hanebuechenes/synapsNOISE/production/bom.csv

Designator | Footprint | Quantity | Value | LCSC Part #
C1, C2, C20, C3, C4, C5, C6 | 0603 | 7 | 100nF
C10, C11, C14, C7 | 0603 | 4 | 100nF 50V X7R
C12, C8 | CP_Elec_6.3x7.7 | 2 | 100uF 25V
C13, C9 | 0805 | 2 | 10uF 25V X7R
C15, C27, C33 | 0603 | 3 | 1nF
C16, C23 | 0603 | 2 | 10u
C17 | 0603 | 1 | 10nF
C18, C19 | 0603 | 2 | 1uF
C21 | 0603 | 1 | 1u
C22 | 0603 | 1 | 100p
C24, C31 | 0603 | 2 | 4,7nF
C25 | 0603 | 1 | 6,8nF
C26, C32 | 0603 | 2 | 2,2nF
C28, C30 | 0603 | 2 | 68p
C29 | 0603 | 1 | 1n
C34 | 0603 | 1 | 100pF
D1, D2 | D_SMA-SMB_Universal_Handsoldering | 2 | MBRA140T3G
D3 | D_SOD-123 | 1 | 1N4733A
D4, D5 | D_SOD-123 | 2 | 1N4148W
F1, F2 | 1210 | 2 | Polyfuse
FB1, FB2 | 0603 | 2 | 120R@100MHz 2A
J1 | PinHeader_2x05_P2.54mm_Vertical | 1 | Eurorack Header
J2 | PJ301M-12 | 1 | White Out
J3 | PJ301M-12 | 1 | Red Out
J4 | PJ301M-12 | 1 | Blue Out
J5 | PJ301M-12 | 1 | Violet Out
J6 | PJ301M-12 | 1 | Pink Out
J7 | PJ301M-12 | 1 | Grainy Out
J8 | PJ301M-12 | 1 | J_Grainy_CV
J9 | PJ301M-12 | 1 | Mix Out
MIX_BLUE1, MIX_GRAINY1, MIX_PINK1, MIX_RED1, MIX_VIOLET1, MIX_WHITE1, RV_GRAINY_CV1 | RES-TH_RK09K1130A70 | 7 | B100k
NOISELEVEL1 | RES-TH_RK09K1130A70 | 1 | 500k
Q1 | TO-92_Inline | 1 | BC337
R1 | 0603 | 1 | 1M
R10 | 0603 | 1 | 470k
R11, R33, R35, R4, R6, R9 | 0603 | 6 | 10k
R12, R15, R21, R25, R31, R47 | 0603 | 6 | 1k
R13, R17, R26 | 0603 | 3 | 51k
R14, R27, R5 | 0603 | 3 | 47k
R16, R28, R36 | 0603 | 3 | 200k
R18, R22 | 0603 | 2 | 8,2k
R19, R23 | 0603 | 2 | 33k
R2, R29, R3, R32, R34, R39, R40, R41, R42, R43, R44, R45, R46, R7, R8 | 0603 | 15 | 100k
R20, R24, R37 | 0603 | 3 | 4,7k
R30 | 0603 | 1 | 20k
R38 | 0603 | 1 | 3,3k
RV_BLUE1, RV_CHARACTER1, RV_VIOLET1 | RES-TH_RK09K1130A70 | 3 | 100k
RV_GRAININESS1 | RES-TH_RK09K1130A70 | 1 | 50k
RV_PINK1, RV_RED1 | RES-TH_RK09K1130A70 | 2 | 1M
SW1 | SW_NKK_GW12LJP | 1 | SW_SP3T
U1, U2 | SOIC-14_3.9x8.7mm_P1.27mm | 2 | TL074
U3 | SOIC-8_3.9x4.9mm_P1.27mm | 1 | TL072
U4 | SOP-14_L8.7-W3.9-P1.27-LS6.0-BL | 1 | CD4093BM_C5456626 | C5456626
