hanebuechenes/synapsNOISE/(list of files, drawings)

Other design files:
sch_data.json
