hanebuechenes/synapsNOISE/synapsNOISE.kicad_pcb

## KiCad design synapsNOISE.kicad_pcb (2026-11-06)

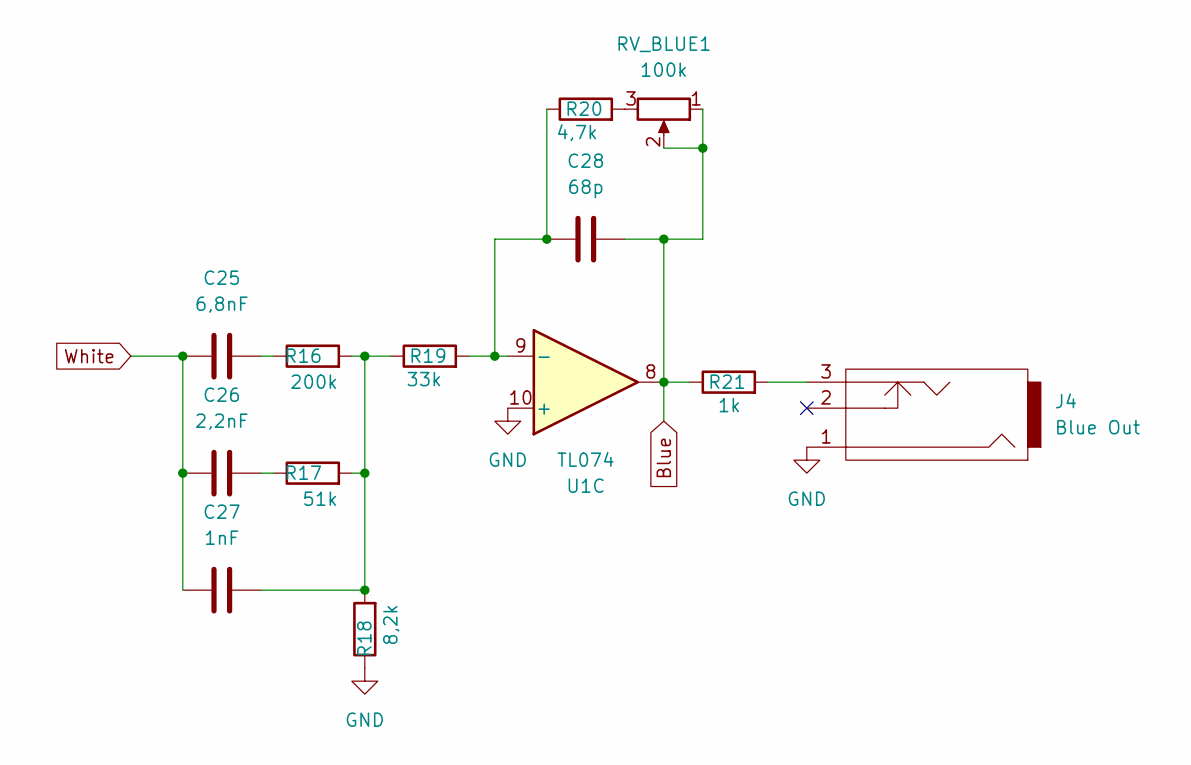
[picture p1: schematic bluenoise.kicad_sch]

Parts:
C25: 6,8nF; C_0603_1608Metric_Pad1.08x0.95mm_HandSolder
C26: 2,2nF; C_0603_1608Metric_Pad1.08x0.95mm_HandSolder
C27: 1nF; C_0603_1608Metric_Pad1.08x0.95mm_HandSolder
C28: 68p; C_0603_1608Metric_Pad1.08x0.95mm_HandSolder
J4: Blue Out; PJ301M-12; MFG Part Number WQP-WQP518MA; Digikey Part Number N/A
R16: 200k; R_0603_1608Metric_Pad0.98x0.95mm_HandSolder
R17: 51k; R_0603_1608Metric_Pad0.98x0.95mm_HandSolder
R18: 8,2k; R_0603_1608Metric_Pad0.98x0.95mm_HandSolder
R19: 33k; R_0603_1608Metric_Pad0.98x0.95mm_HandSolder
R20: 4,7k; R_0603_1608Metric_Pad0.98x0.95mm_HandSolder
R21: 1k; R_0603_1608Metric_Pad0.98x0.95mm_HandSolder
RV_BLUE1: 100k; RES-TH_RK09K1130A70
U1: TL074; SOIC-14_3.9x8.7mm_P1.27mm

Connections:
GND: J4.1, R18.1, U1.10 (+); also elsewhere on the board
unnamed: C25.1, R16.1
unnamed: C26.1, R17.1
unnamed: C27.1, R16.2, R17.2, R18.2, R19.1
unnamed: C28.1, R21.1, RV_BLUE1.1, RV_BLUE1.2, U1.8
unnamed: J4.3, R21.2
unnamed: R20.2, RV_BLUE1.3
unnamed: C28.2, R19.2, R20.1, U1.9 (-)
White: C25.2, C26.2, C27.2; also elsewhere on the board

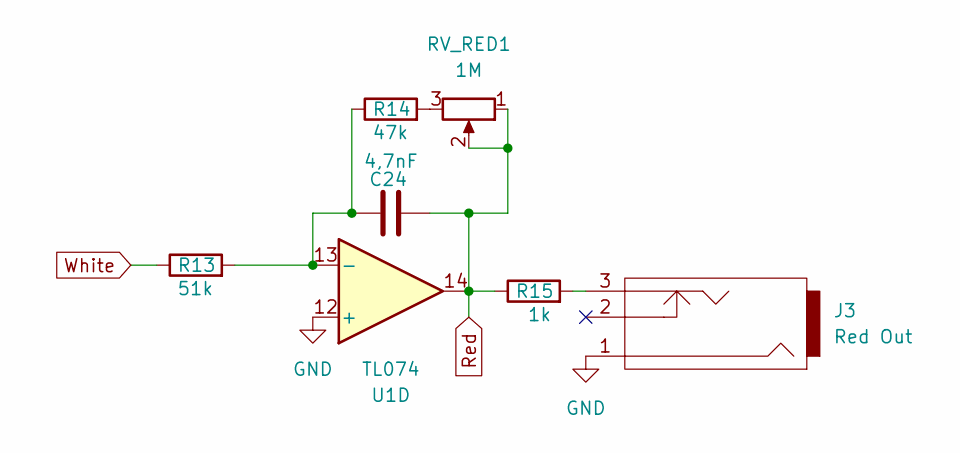
[picture p2: schematic rednoise.kicad_sch]

Parts:
C24: 4,7nF; C_0603_1608Metric_Pad1.08x0.95mm_HandSolder
J3: Red Out; PJ301M-12; MFG Part Number WQP-WQP518MA; Digikey Part Number N/A
R13: 51k; R_0603_1608Metric_Pad0.98x0.95mm_HandSolder
R14: 47k; R_0603_1608Metric_Pad0.98x0.95mm_HandSolder
R15: 1k; R_0603_1608Metric_Pad0.98x0.95mm_HandSolder
RV_RED1: 1M; RES-TH_RK09K1130A70
U1: TL074; SOIC-14_3.9x8.7mm_P1.27mm

Connections:
GND: J3.1, U1.12 (+); also elsewhere on the board
unnamed: C24.1, R15.1, RV_RED1.1, RV_RED1.2, U1.14
unnamed: J3.3, R15.2
unnamed: R14.2, RV_RED1.3
unnamed: C24.2, R13.2, R14.1, U1.13 (-)
White: R13.1; also elsewhere on the board

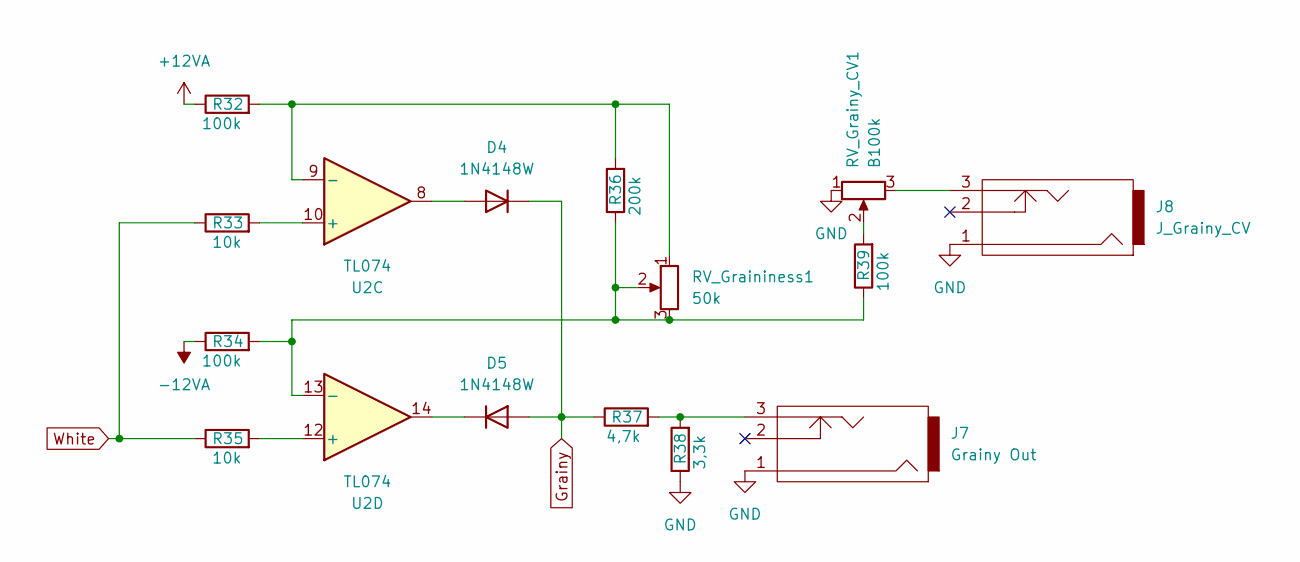
[picture p3: schematic grainyout.kicad_sch]

Parts:
D4, D5: 1N4148W; D_SOD-123
J7: Grainy Out; PJ301M-12; MFG Part Number WQP-WQP518MA; Digikey Part Number N/A
J8: J_Grainy_CV; PJ301M-12; MFG Part Number WQP-WQP518MA; Digikey Part Number N/A
R32, R34, R39: 100k; R_0603_1608Metric_Pad0.98x0.95mm_HandSolder
R33, R35: 10k; R_0603_1608Metric_Pad0.98x0.95mm_HandSolder
R36: 200k; R_0603_1608Metric_Pad0.98x0.95mm_HandSolder
R37: 4,7k; R_0603_1608Metric_Pad0.98x0.95mm_HandSolder
R38: 3,3k; R_0603_1608Metric_Pad0.98x0.95mm_HandSolder
RV_Graininess1: 50k; RES-TH_RK09K1130A70
RV_Grainy_CV1: B100k; RES-TH_RK09K1130A70
U2: TL074; SOIC-14_3.9x8.7mm_P1.27mm

Connections:
+12VA: R32.1; also elsewhere on the board
-12VA: R34.1; also elsewhere on the board
GND: J7.1, J8.1, R38.1, RV_Grainy_CV1.1; also elsewhere on the board
unnamed: D4.2 (A), U2.8
unnamed: D4.1 (K), D5.2 (A), R37.1
unnamed: D5.1 (K), U2.14
unnamed: J7.3, R37.2, R38.2
unnamed: J8.3, RV_Grainy_CV1.3
unnamed: R39.2, RV_Grainy_CV1.2
unnamed: R33.2, U2.10 (+)
unnamed: R32.2, R36.2, RV_Graininess1.1, U2.9 (-)
unnamed: R35.2, U2.12 (+)
unnamed: R34.2, R36.1, R39.1, RV_Graininess1.2, RV_Graininess1.3, U2.13 (-)
White: R33.1, R35.1; also elsewhere on the board

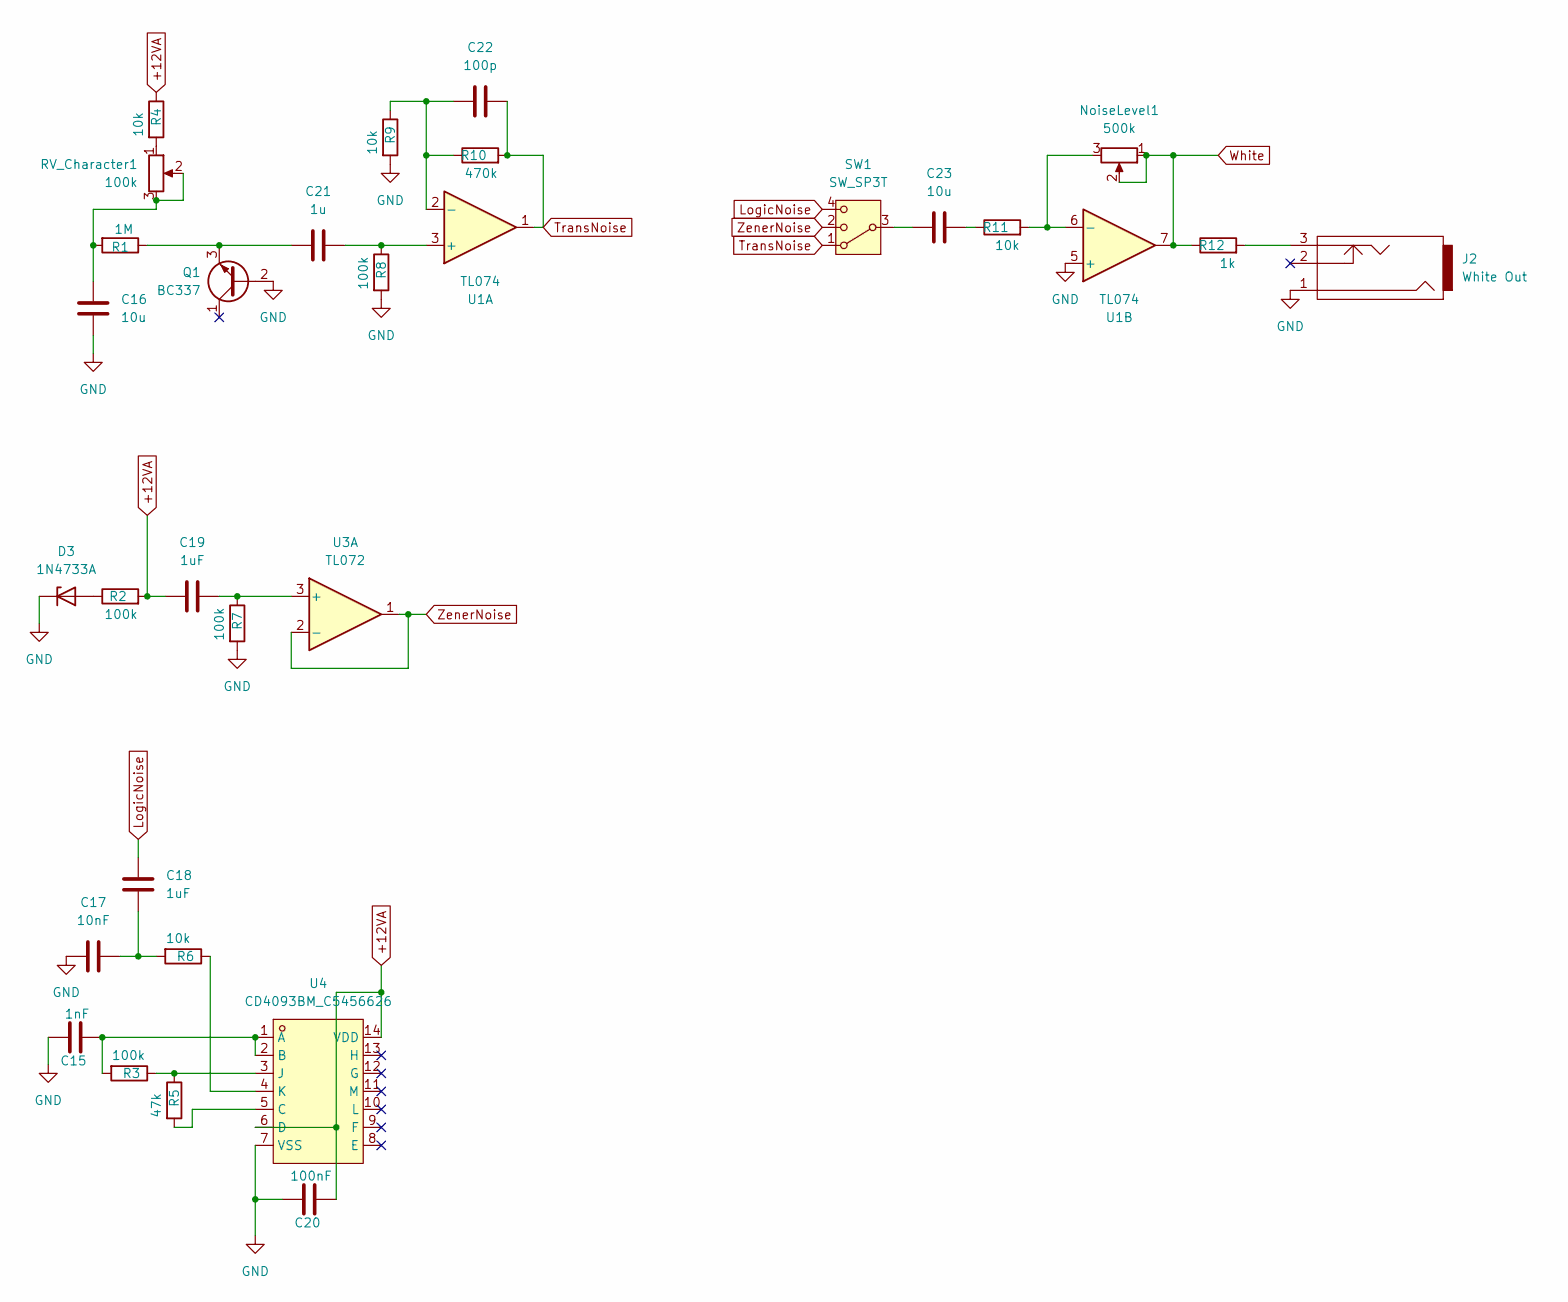
[picture p4: schematic noisesources.kicad_sch]

Parts:
C15: 1nF; C_0603_1608Metric_Pad1.08x0.95mm_HandSolder
C16, C23: 10u; C_0603_1608Metric_Pad1.08x0.95mm_HandSolder
C17: 10nF; C_0603_1608Metric_Pad1.08x0.95mm_HandSolder
C18, C19: 1uF; C_0603_1608Metric_Pad1.08x0.95mm_HandSolder
C20: 100nF; C_0603_1608Metric_Pad1.08x0.95mm_HandSolder
C21: 1u; C_0603_1608Metric_Pad1.08x0.95mm_HandSolder
C22: 100p; C_0603_1608Metric_Pad1.08x0.95mm_HandSolder
D3: 1N4733A; D_SOD-123
J2: White Out; PJ301M-12; MFG Part Number WQP-WQP518MA; Digikey Part Number N/A
NoiseLevel1: 500k; RES-TH_RK09K1130A70
Q1: BC337; TO-92_Inline
R1: 1M; R_0603_1608Metric_Pad0.98x0.95mm_HandSolder
R2, R3, R7, R8: 100k; R_0603_1608Metric_Pad0.98x0.95mm_HandSolder
R4, R6, R9, R11: 10k; R_0603_1608Metric_Pad0.98x0.95mm_HandSolder
R5: 47k; R_0603_1608Metric_Pad0.98x0.95mm_HandSolder
R10: 470k; R_0603_1608Metric_Pad0.98x0.95mm_HandSolder
R12: 1k; R_0603_1608Metric_Pad0.98x0.95mm_HandSolder
RV_Character1: 100k; RES-TH_RK09K1130A70
SW1: SW_SP3T; SW_NKK_GW12LJP
U1: TL074; SOIC-14_3.9x8.7mm_P1.27mm
U3: TL072; SOIC-8_3.9x4.9mm_P1.27mm
U4: CD4093BM_C5456626; SOP-14_L8.7-W3.9-P1.27-LS6.0-BL; MPN CD4093BM; LCSC Part C5456626

Connections:
+12VA: C19.2, C20.2, R2.2, R4.1, U4.6 (D), U4.14 (VDD); also elsewhere on the board
GND: C15.1, C16.1, C17.2, C20.1, D3.1 (K), J2.1, Q1.2 (B), R7.2, R8.2, R9.2, U1.5 (+), U4.7 (VSS); also elsewhere on the board
LogicNoise: C18.1, SW1.4
unnamed: C16.2, R1.2, RV_Character1.2, RV_Character1.3
unnamed: C17.1, C18.2, R6.2
unnamed: C23.1, R11.1
unnamed: C23.2, SW1.3
unnamed: D3.2 (A), R2.1
unnamed: J2.3, R12.2
unnamed: C21.2, Q1.3 (E), R1.1
unnamed: R4.2, RV_Character1.1
unnamed: C21.1, R8.1, U1.3 (+)
unnamed: C22.2, R9.1, R10.1, U1.2 (-)
unnamed: NoiseLevel1.3, R11.2, U1.6 (-)
unnamed: C19.1, R7.1, U3.3 (+)
unnamed: C15.2, R3.2, U4.1 (A), U4.2 (B)
unnamed: R5.2, U4.5 (C)
unnamed: R3.1, R5.1, U4.3 (J)
unnamed: R6.1, U4.4 (K)
TransNoise: C22.1, R10.2, SW1.1, U1.1
White: NoiseLevel1.1, NoiseLevel1.2, R12.1, U1.7; also elsewhere on the board
ZenerNoise: SW1.2, U3.1, U3.2 (-)

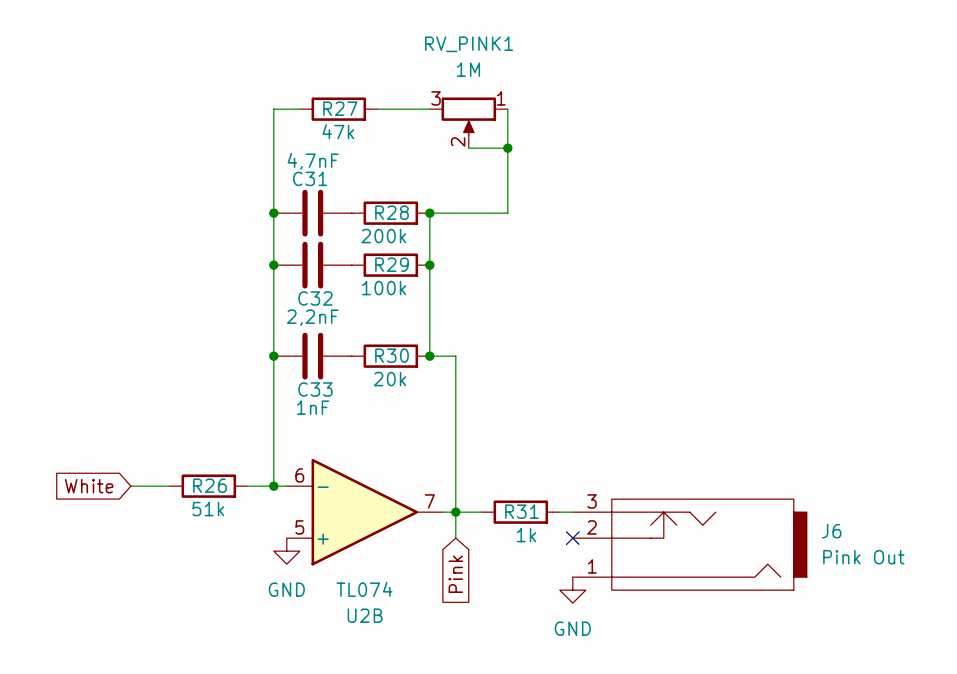
[picture p5: schematic pinknoise.kicad_sch]

Parts:
C31: 4,7nF; C_0603_1608Metric_Pad1.08x0.95mm_HandSolder
C32: 2,2nF; C_0603_1608Metric_Pad1.08x0.95mm_HandSolder
C33: 1nF; C_0603_1608Metric_Pad1.08x0.95mm_HandSolder
J6: Pink Out; PJ301M-12; MFG Part Number WQP-WQP518MA; Digikey Part Number N/A
R26: 51k; R_0603_1608Metric_Pad0.98x0.95mm_HandSolder
R27: 47k; R_0603_1608Metric_Pad0.98x0.95mm_HandSolder
R28: 200k; R_0603_1608Metric_Pad0.98x0.95mm_HandSolder
R29: 100k; R_0603_1608Metric_Pad0.98x0.95mm_HandSolder
R30: 20k; R_0603_1608Metric_Pad0.98x0.95mm_HandSolder
R31: 1k; R_0603_1608Metric_Pad0.98x0.95mm_HandSolder
RV_PINK1: 1M; RES-TH_RK09K1130A70
U2: TL074; SOIC-14_3.9x8.7mm_P1.27mm

Connections:
GND: J6.1, U2.5 (+); also elsewhere on the board
unnamed: C31.1, R28.1
unnamed: C32.2, R29.1
unnamed: C33.2, R30.1
unnamed: J6.3, R31.2
unnamed: R27.2, RV_PINK1.3
unnamed: R28.2, R29.2, R30.2, R31.1, RV_PINK1.1, RV_PINK1.2, U2.7
unnamed: C31.2, C32.1, C33.1, R26.2, R27.1, U2.6 (-)
White: R26.1; also elsewhere on the board

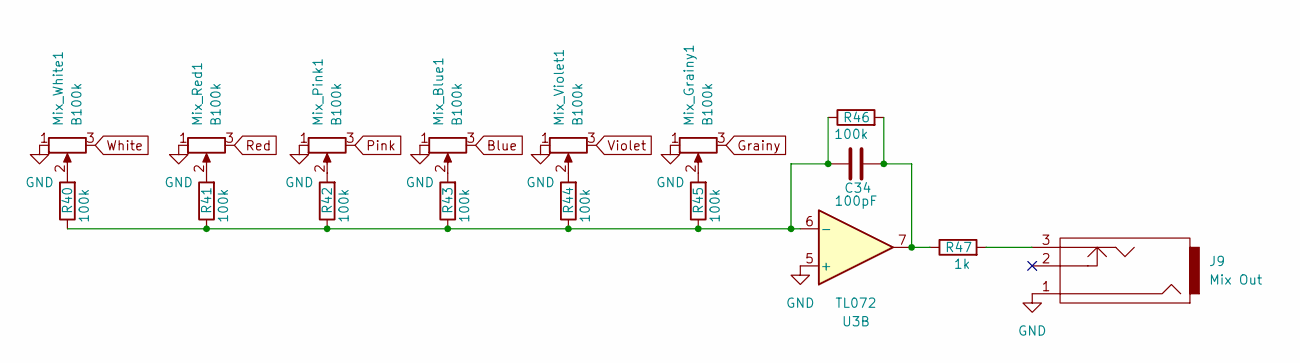
[picture p6: schematic mixer.kicad_sch]

Parts:
C34: 100pF; C_0603_1608Metric_Pad1.08x0.95mm_HandSolder
J9: Mix Out; PJ301M-12; MFG Part Number WQP-WQP518MA; Digikey Part Number N/A
Mix_Blue1: B100k; RES-TH_RK09K1130A70
Mix_Grainy1: B100k; RES-TH_RK09K1130A70
Mix_Pink1: B100k; RES-TH_RK09K1130A70
Mix_Red1: B100k; RES-TH_RK09K1130A70
Mix_Violet1: B100k; RES-TH_RK09K1130A70
Mix_White1: B100k; RES-TH_RK09K1130A70
R40, R41, R42, R43, R44, R45, R46: 100k; R_0603_1608Metric_Pad0.98x0.95mm_HandSolder
R47: 1k; R_0603_1608Metric_Pad0.98x0.95mm_HandSolder
U3: TL072; SOIC-8_3.9x4.9mm_P1.27mm

Connections:
Blue: Mix_Blue1.3
GND: J9.1, Mix_Blue1.1, Mix_Grainy1.1, Mix_Pink1.1, Mix_Red1.1, Mix_Violet1.1, Mix_White1.1, U3.5 (+); also elsewhere on the board
Grainy: Mix_Grainy1.3
unnamed: C34.2, R46.2, R47.1, U3.7
unnamed: J9.3, R47.2
unnamed: Mix_Blue1.2, R43.2
unnamed: Mix_Grainy1.2, R45.2
unnamed: Mix_Pink1.2, R42.2
unnamed: Mix_Red1.2, R41.2
unnamed: Mix_Violet1.2, R44.2
unnamed: Mix_White1.2, R40.2
unnamed: C34.1, R40.1, R41.1, R42.1, R43.1, R44.1, R45.1, R46.1, U3.6 (-)
Pink: Mix_Pink1.3
Red: Mix_Red1.3
Violet: Mix_Violet1.3
White: Mix_White1.3; also elsewhere on the board

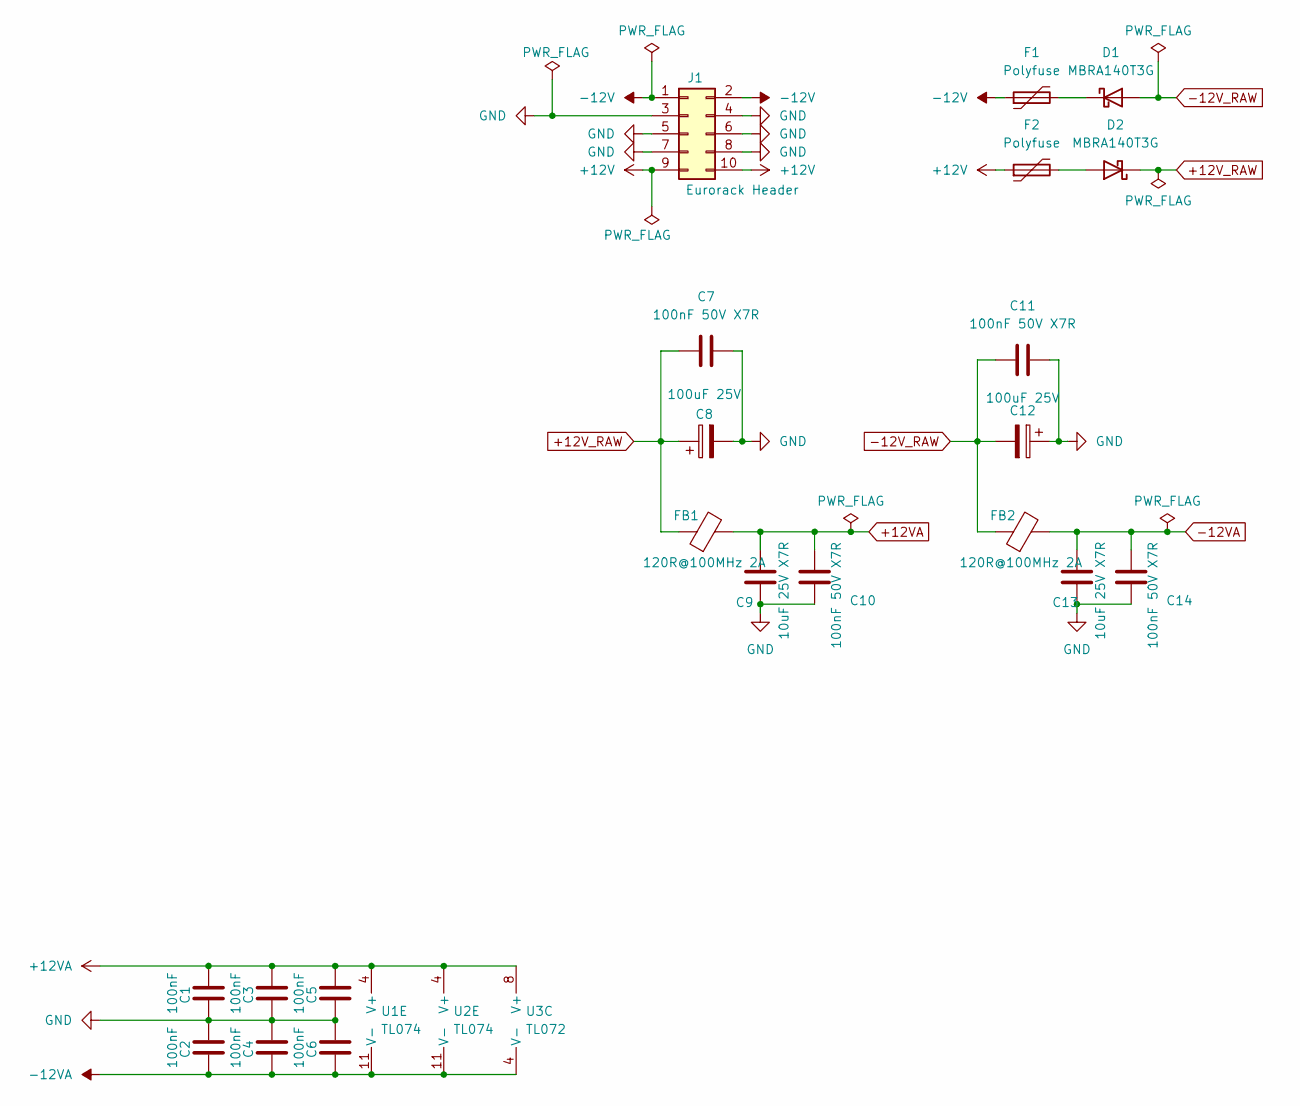
[picture p7: schematic power.kicad_sch]

Parts:
C1, C2, C3, C4, C5, C6: 100nF; C_0603_1608Metric_Pad1.08x0.95mm_HandSolder
C7, C10, C11, C14: 100nF 50V X7R; C_0603_1608Metric_Pad1.08x0.95mm_HandSolder
C8, C12: 100uF 25V; CP_Elec_6.3x7.7
C9, C13: 10uF 25V X7R; C_0805_2012Metric_Pad1.18x1.45mm_HandSolder
D1, D2: MBRA140T3G; D_SMA-SMB_Universal_Handsoldering
F1, F2: Polyfuse; Fuse_1210_3225Metric
FB1, FB2: 120R@100MHz 2A; L_0603_1608Metric_Pad1.05x0.95mm_HandSolder
J1: Eurorack Header; PinHeader_2x05_P2.54mm_Vertical
U1, U2: TL074; SOIC-14_3.9x8.7mm_P1.27mm
U3: TL072; SOIC-8_3.9x4.9mm_P1.27mm

Connections:
+12V: F2.1, J1.9, J1.10
+12VA: C1.1, C3.1, C5.1, C9.1, C10.1, FB1.2, U1.4 (V+), U2.4 (V+), U3.8 (V+); also elsewhere on the board
+12V_RAW: C7.1, C8.1, D2.1 (K), FB1.1
-12V: F1.1, J1.1, J1.2
-12VA: C2.2, C4.2, C6.2, C13.1, C14.1, FB2.2, U1.11 (V-), U2.11 (V-), U3.4 (V-); also elsewhere on the board
-12V_RAW: C11.1, C12.2, D1.2 (A), FB2.1
GND: C1.2, C2.1, C3.2, C4.1, C5.2, C6.1, C7.2, C8.2, C9.2, C10.2, C11.2, C12.1, C13.2, C14.2, J1.3, J1.4, J1.5, J1.6, J1.7, J1.8; also elsewhere on the board
unnamed: D1.1 (K), F1.2
unnamed: D2.2 (A), F2.2

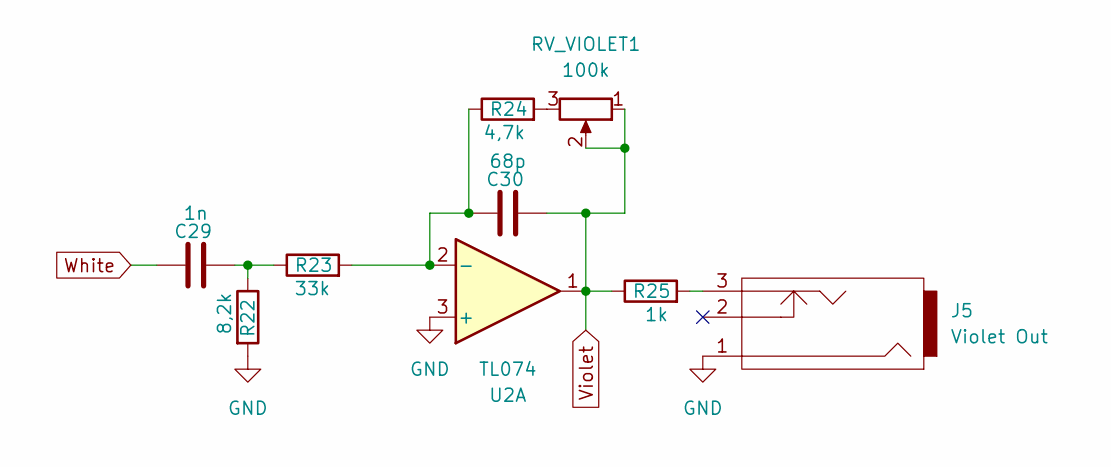
[picture p8: schematic violetnoise.kicad_sch]

Parts:
C29: 1n; C_0603_1608Metric_Pad1.08x0.95mm_HandSolder
C30: 68p; C_0603_1608Metric_Pad1.08x0.95mm_HandSolder
J5: Violet Out; PJ301M-12; MFG Part Number WQP-WQP518MA; Digikey Part Number N/A
R22: 8,2k; R_0603_1608Metric_Pad0.98x0.95mm_HandSolder
R23: 33k; R_0603_1608Metric_Pad0.98x0.95mm_HandSolder
R24: 4,7k; R_0603_1608Metric_Pad0.98x0.95mm_HandSolder
R25: 1k; R_0603_1608Metric_Pad0.98x0.95mm_HandSolder
RV_VIOLET1: 100k; RES-TH_RK09K1130A70
U2: TL074; SOIC-14_3.9x8.7mm_P1.27mm

Connections:
GND: J5.1, R22.2, U2.3 (+); also elsewhere on the board
unnamed: C29.1, R22.1, R23.1
unnamed: C30.1, R25.1, RV_VIOLET1.1, RV_VIOLET1.2, U2.1
unnamed: J5.3, R25.2
unnamed: R24.2, RV_VIOLET1.3
unnamed: C30.2, R23.2, R24.1, U2.2 (-)
White: C29.2; also elsewhere on the board

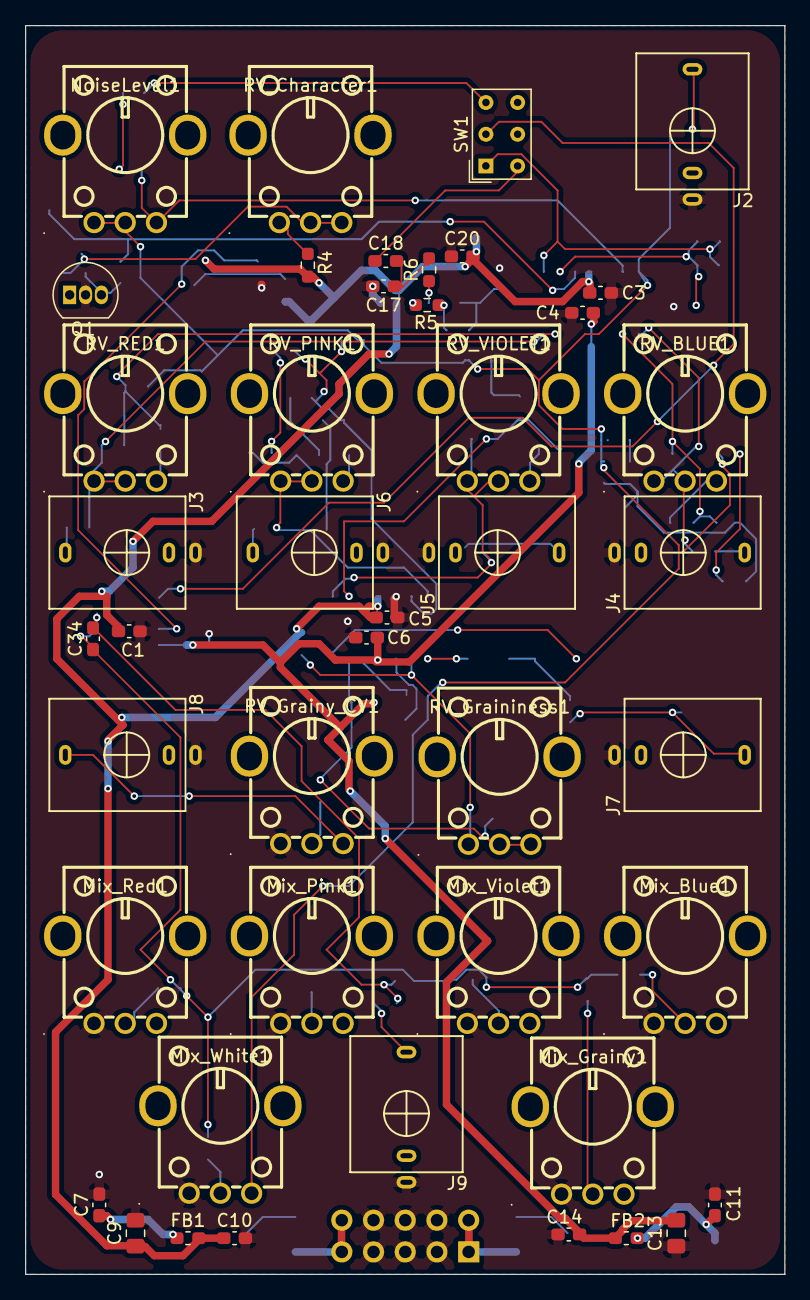
[picture p9: board synapsNOISE.kicad_pcb from above]

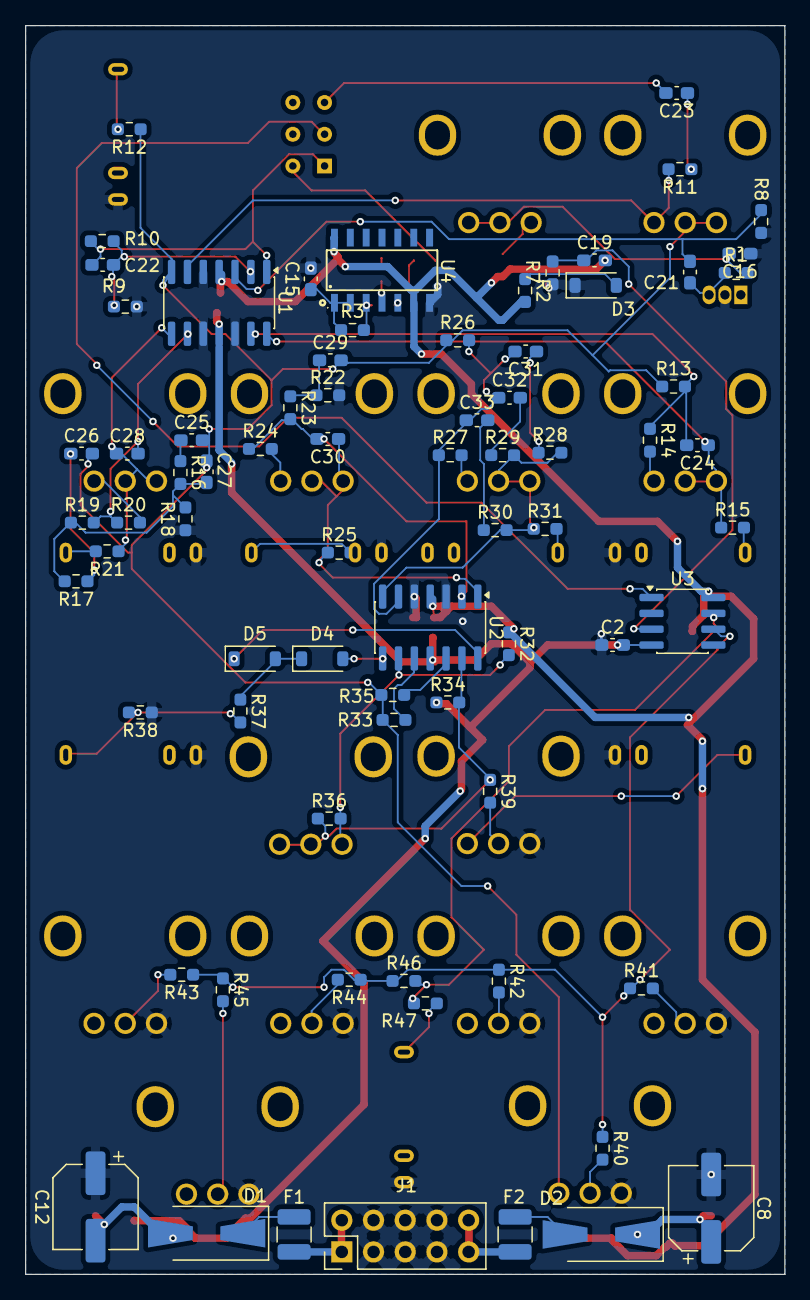
[picture p10: board synapsNOISE.kicad_pcb from below]

Board: 2 copper layers, 60.8 x 100.0 mm, 119 parts (75 on the bottom side), 71 nets.
